jh442/run-type-58/README.md

# run-type-58

58 split keyboard layout design project.

https://github.com/zmkfirmware/zmk/blob/main/app/boards/shields/lily58/lily58.dtsi
