jh442/run-type-58/files/STLs/kailh-choc/1U.3mf

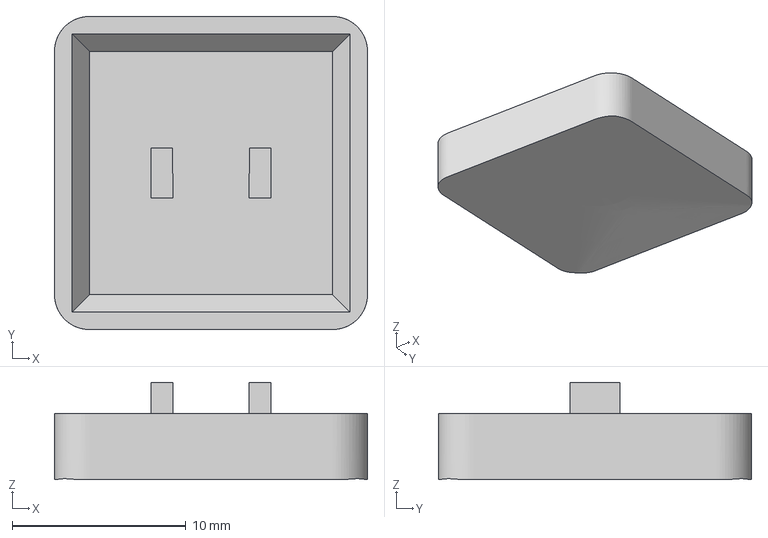
[picture p4: CAD file, 2024-02-04]
files/STLs/kailh-choc/1U.3mf
18.0 x 18.0 x 5.60 mm
