jh442/run-type-58/files/STLs/Right Hex Lift.3mf

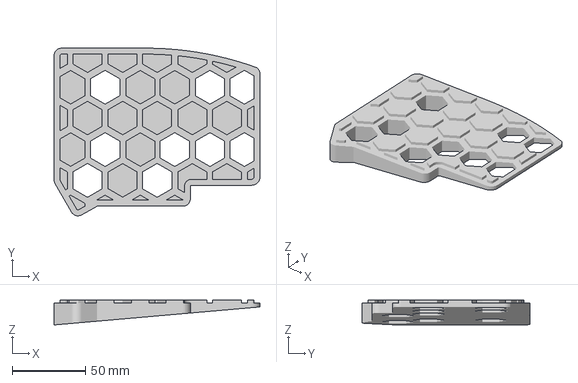
[picture p5: CAD file, 2024-02-04]
files/STLs/Right Hex Lift.3mf
140.5 x 114.4 x 17.0 mm
