jh442/run-type-58/files/STLs/Right Angle Holder.3mf

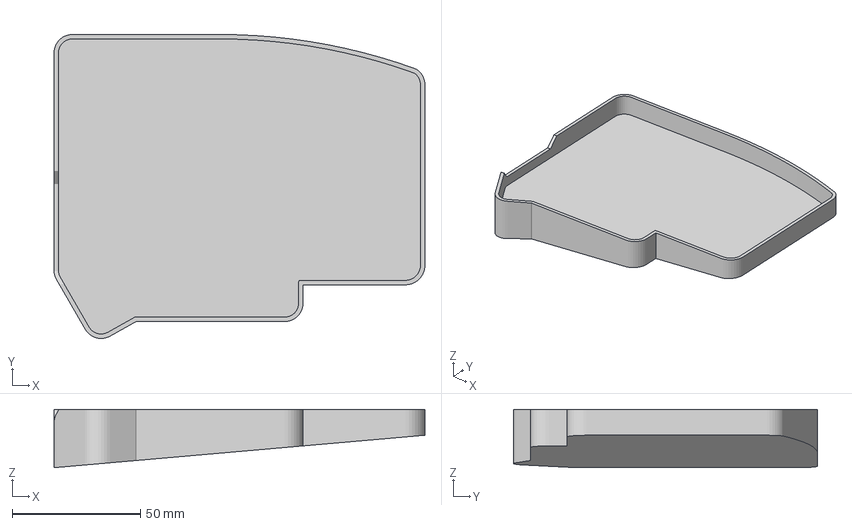
[picture p6: CAD file, 2023-12-14]
files/STLs/Right Angle Holder.3mf
144.5 x 118.4 x 22.7 mm
