jh442/run-type-58/files/STLs/Left Key Plate.3mf

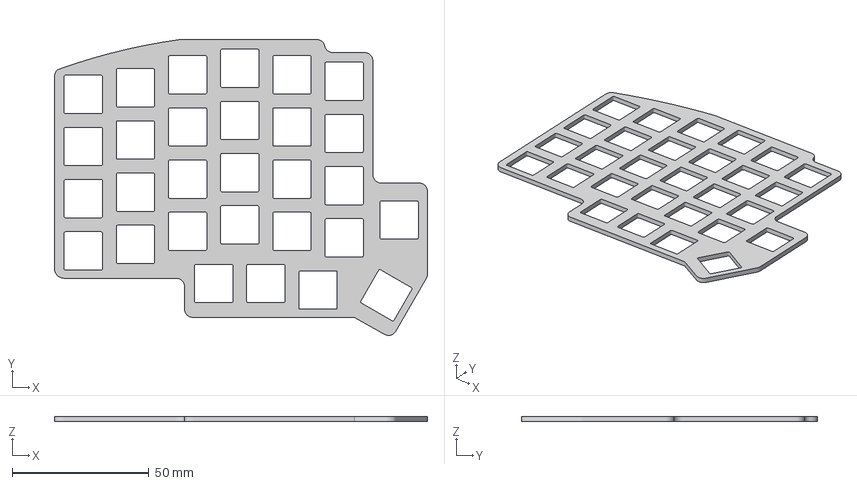
[picture p7: CAD file, 2023-12-14]
files/STLs/Left Key Plate.3mf
136.2 x 108.1 x 2.00 mm
