jh442/run-type-58/files/STLs/kailh-choc/1U homing.3mf

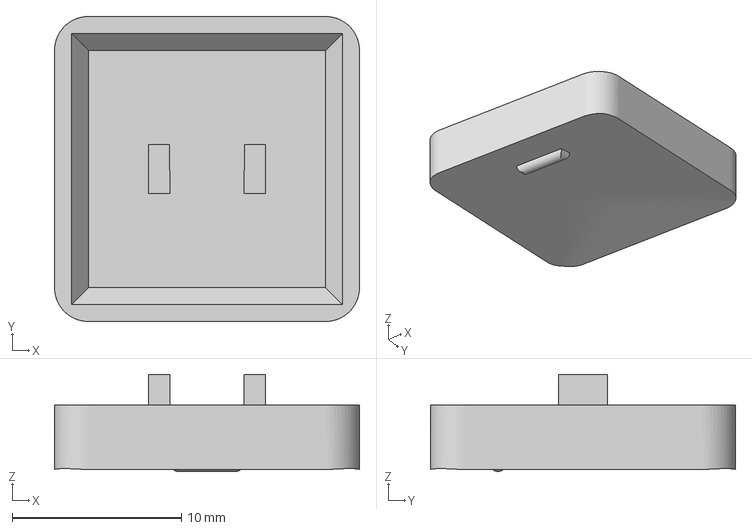
[picture p8: CAD file, 2024-02-04]
files/STLs/kailh-choc/1U homing.3mf
18.0 x 18.0 x 5.73 mm
