jh442/run-type-58/files/STLs/Left_Case.3mf

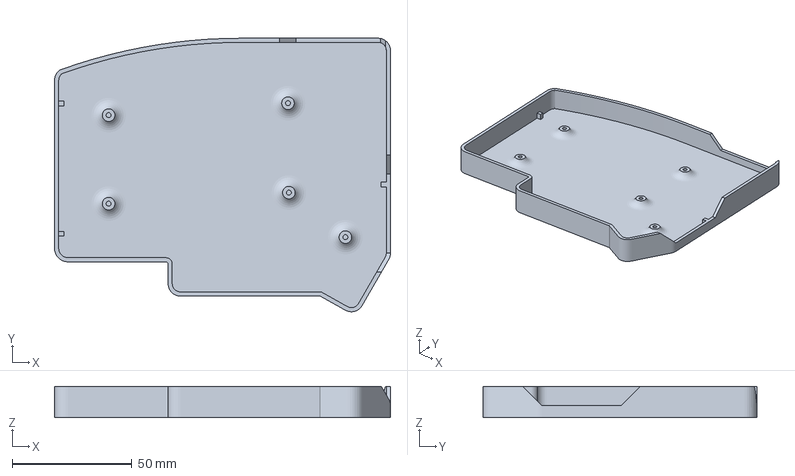
[picture p9: CAD file, 2023-12-14]
files/STLs/Left_Case.3mf
140.5 x 114.4 x 13.0 mm
