jh442/run-type-58/files/STLs/kailh-choc/1.3ukey vertical.3mf

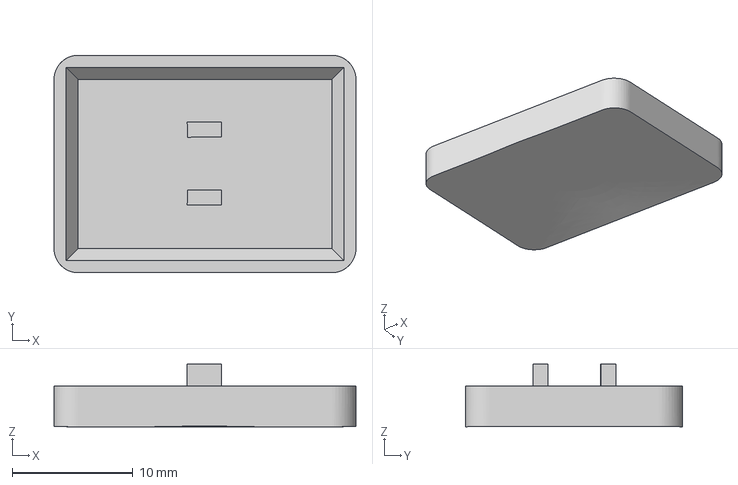
[picture p10: CAD file, 2024-02-04]
files/STLs/kailh-choc/1.3ukey vertical.3mf
25.0 x 18.0 x 5.20 mm
