jh442/run-type-58/files/STLs/Left Plate.3mf

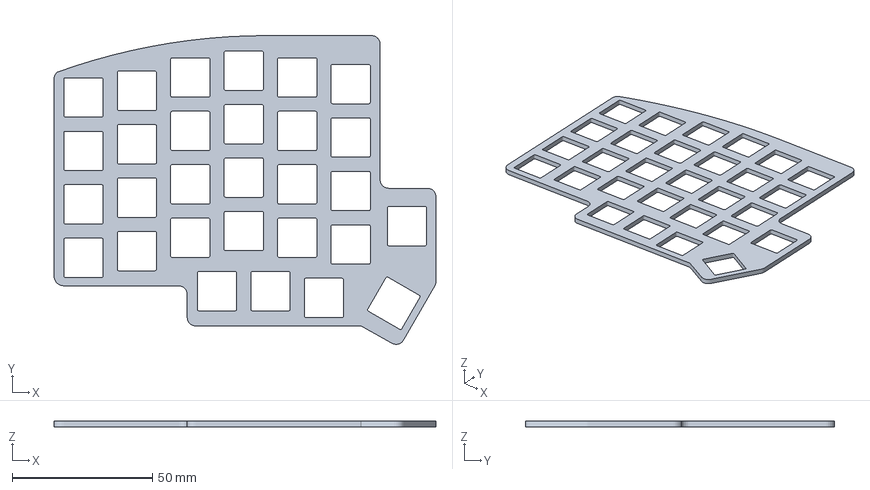
[picture p11: CAD file, 2023-12-14]
files/STLs/Left Plate.3mf
136.2 x 110.1 x 2.00 mm
