jh442/run-type-58/files/STLs/Right Case.3mf

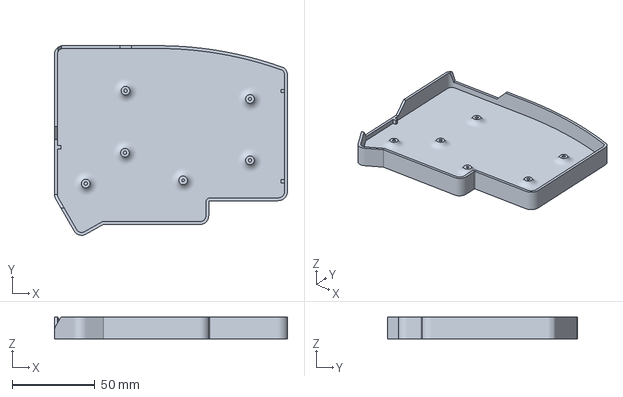
[picture p14: CAD file, 2023-12-14]
files/STLs/Right Case.3mf
140.5 x 114.4 x 13.0 mm
