jh442/run-type-58/files/STLs/Right Hand Holder.3mf

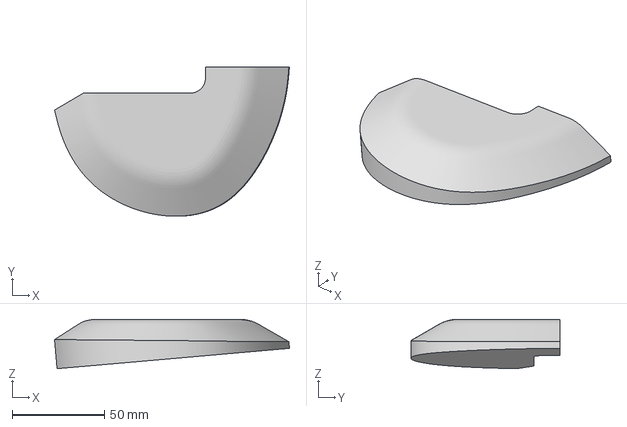
[picture p16: CAD file, 2023-12-14]
files/STLs/Right Hand Holder.3mf
127.5 x 81.1 x 26.8 mm
