jh442/run-type-58/(list of files, cad)

Other CAD files:
files/STLs/kailh-choc/Right Arrow in.3mf
files/STLs/kailh-choc/Left Arrow in.3mf
files/STLs/Left Plate_2mm.3mf
files/STLs/kailh-choc/Up Arrow in.3mf
files/STLs/kailh-choc/1.3u KeyCap.3mf
files/STLs/kailh-choc/Down Arrow in.3mf
files/STLs/Right Key Plate.3mf
files/STLs/Left Angle Holder.3mf
files/STLs/Right Hex Angle.3mf
files/STLs/Right Plate_2mm.3mf
