jh442/run-type-58/(commit log)

2023-10-01 Initial commit of kicad files
    [RunType58-2.kicad_pcb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]
2023-10-01 Removing some of the dup / backup files
    [RunType58-2.kicad_pcb]
2023-10-05 Files that were ordered for manufacturing
    [RunType58-B_Cu.gbl, RunType58-B_Mask.gbs, RunType58-B_Paste.gbp, RunType58-B_Silkscreen.gbo, RunType58-Edge_Cuts.gm1, RunType58-F_Cu.gtl, RunType58-F_Mask.gts, RunType58-F_Paste.gtp]
2023-10-15 Setting up the initial files I think I need
    [RunType58-2.kicad_pcb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]
2023-10-22 gathering some of the updates
    [RunType58.kicad_sch]
2023-10-26 PCB check in
2023-10-30 Adding some of the files for the case
    [Left Plate.3mf, Left Plate_2mm.3mf, Left_Case.3mf, Right Case.3mf, Right Plate_2mm.3mf]
2023-10-31 Updated case with stronger case around the sockets
    [Left_Case.3mf, Right Case.3mf]
2023-11-02 Adding some test holders
    [Left Angle Holder.3mf, Right Angle Holder.3mf]
2023-11-02 other minor switch arounds
2023-11-06 Moving the power settings to each config
    I want to set this to an hour before it sleeps. Long enough to not time out during work, but also will go asleep during the night or long meetings.
2023-11-25 Added Angle holders
    [Left Angle Holder.3mf, Right Angle Holder.3mf]
2023-12-02 Adding a hex pattern version
    [Right Angle Holder_hex.3mf]
2023-12-14 Checking in some more updates to the smf files I used to print
    [Left Key Plate.3mf, Right Case Hex.3mf, Right Case Hex_0.25mm_offset.3mf, Right Hand Holder.3mf, Right Hex Angle.3mf, Right Key Plate.3mf]
2024-02-04 Checking in STL file of low profile keycaps
    Adding STL and a very brief readme
    [1.3u KeyCap.3mf, 1.3ukey vertical.3mf, 1U homing.3mf, 1U.3mf, Down Arrow in.3mf, Left Arrow in.3mf, Right Arrow in.3mf, Right Hex Lift.3mf]
2024-12-19 Fixing the board
